gromeck/LatencyMeasure/Ressources/SVG/README

computer-158675.svg 
https://pixabay.com/de/vectors/computer-schreibtisch-arbeitsplatz-158675/
