gromeck/LatencyMeasure/Case/Dimensions-OLED-SSD-1306.png

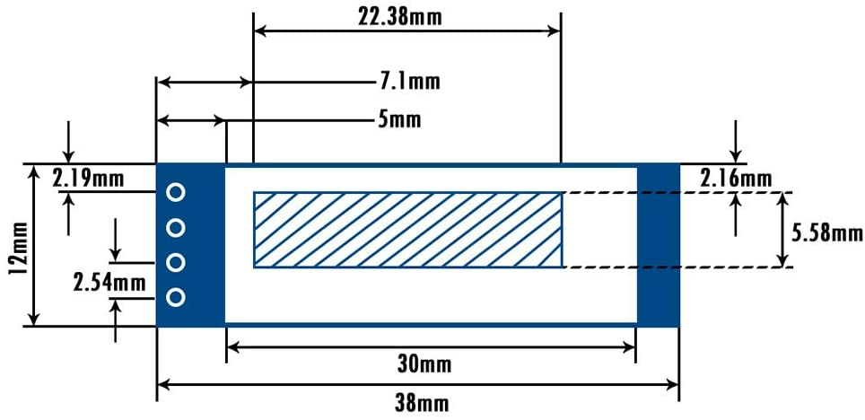
Case/Dimensions-OLED-SSD-1306.png
