gromeck/LatencyMeasure/TestClient/Qt4/README

	install Qt4 development environment (as root)

# apt install qt4-dev-tools

	build the client software

./build.sh
