gromeck/LatencyMeasure/Documentation/LatencyMeasure-Typical-Latencies.ods

Test Client | Environment | Window Manager | Test Client/Environment/Window Manager | min [ms] | avg [ms] | max [ms]
ncurses | console | - | ncurses/console/- | 12 | 21 | 29
ncurses via xterm | X11 | none | ncurses via xterm/X11/none | 10 | 19 | 21
ncurses via xterm | X11 | MATE | ncurses via xterm/X11/MATE | 31 | 44 | 66
FLTK | X11 | none | FLTK/X11/none | 10 | 15 | 23
FLTK | X11 | Gnome Classic | FLTK/X11/Gnome Classic | 26 | 32 | 39
FLTK | X11 | Gnome3 | FLTK/X11/Gnome3 | 26 | 32 | 40
FLTK | X11 | KDE “Plasma” | FLTK/X11/KDE “Plasma” | 14 | 21 | 29
GTK+ | X11 | KDE “Plasma” | GTK+/X11/KDE “Plasma” | 18 | 21 | 29
Qt4 | X11 | KDE “Plasma” | Qt4/X11/KDE “Plasma” | 18 | 30 | 53
FLTK | X11 | MATE | FLTK/X11/MATE | 28 | 41 | 55
GTK+ | X11 | MATE | GTK+/X11/MATE | 26 | 39 | 54
Qt4 | X11 | MATE | Qt4/X11/MATE | 31 | 47 | 54
HTML/Firefox 78.x | X11 | MATE | HTML/Firefox 78.x/X11/MATE | 55 | 65 | 78
HTML/Chrome 83.x | X11 | MATE | HTML/Chrome 83.x/X11/MATE | 67 | 73 | 80
