gromeck/LatencyMeasure/(threads)

Thread 2 (2020-10-19):

Check sensor area right before measurement cycle

gromeck, 2020-10-19:
Before a measurement cycle is done, the device should check that the sensor area is dark again.
This should not change any measuring behavior, but simply double check that the system under test is ready to be measured.

gromeck, 2020-10-19:
Implemented with commit bcda93945c8e4d4c52f2d0d78405658bab7e6465

Closed 2020-10-19.

Thread 4 (2020-10-25):

Improve calibration

gromeck, 2020-10-25:
The device should compute the optimal Uref during the calibration process.
The optimal Uref is the mean value between the lowest and highest Uin.

gromeck, 2020-11-02:
Empiric evaluation turned out that not the optimal Uref is not the mean between the lowest Uin (bright) and the hight Uin (dark), but a value of 80% of of the delta between lowest and highest Uin.
The optimization is implemented with commit d7d07f9f519d3749e5edcaf01a3c88896e707935

Closed 2020-11-02.
