gromeck/LatencyMeasure/Circuit/LatencyMeasure.pdf

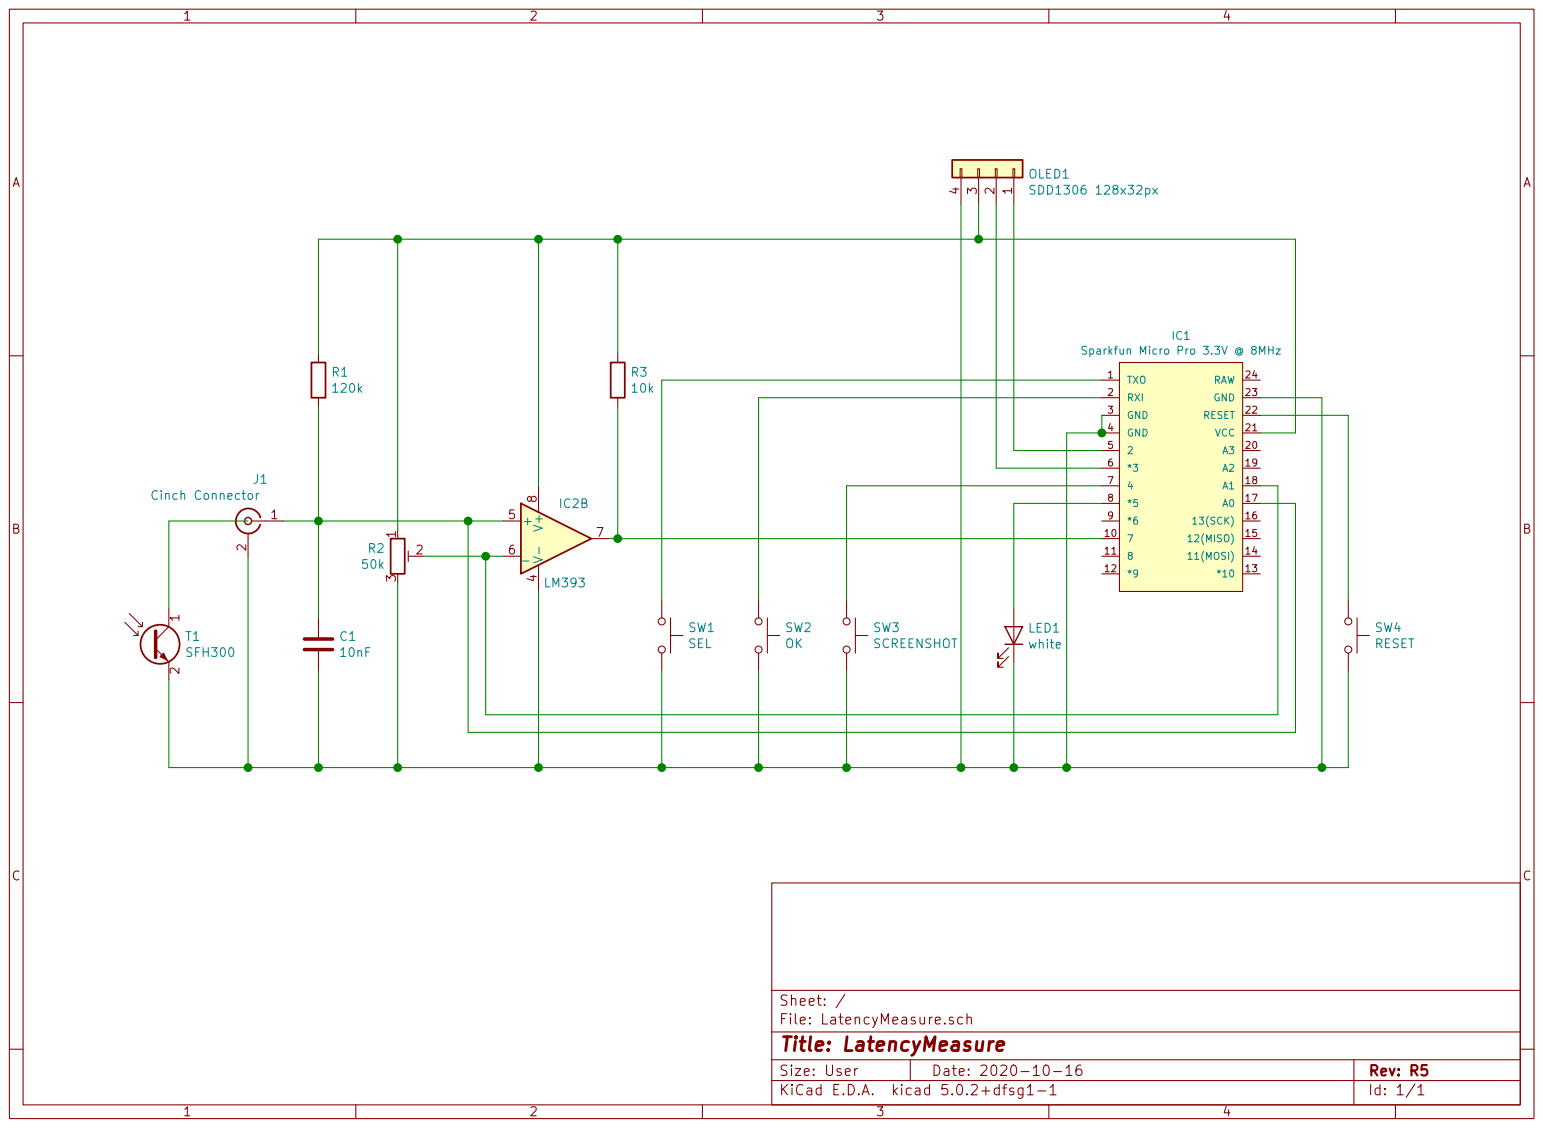
[picture p18: page 1]

File: LatencyMeasure.sch Sheet: / +

LED1 white
