gromeck/LatencyMeasure/Circuit/LatencyMeasure.sch

## KiCad design Circuit/LatencyMeasure.sch (2020-10-24)

Schematic: LatencyMeasure.sch

Parts:
C1: 10nF
IC1: Sparkfun Micro Pro 3.3V @ 8MHz; SPARKFUN_PRO_MICRO
IC2: LM393
J1: Cinch Connector
LED1: white
OLED1: SDD1306 128x32px
R1: 120k
R2: 50k
R3: 10k
SW1: SEL; SW_PUSH_6mm
SW2: OK; SW_PUSH_6mm
SW3: SCREENSHOT; SW_PUSH_6mm
SW4: RESET; SW_PUSH_6mm
T1: SFH300; LED_D5.0mm_Clear
U1: LM393
