gromeck/LatencyMeasure/LatencyMeasure/common.h

/*
  LatencyMeasure

  (c) 2020 Christian.Lorenz@gromeck.de

  common definitions


  This file is part of LatencyMeasure.

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
*/
#ifndef __COMMON_H__
#define __COMMON_H__ 1

#define SERIAL_BAUDRATE           115200

/*
**  in debug mode we produce more code and
**  timing accuracy is bad
*/
#define DEBUG                     0

#if DEBUG
#define FEATURE_CONFIG_MENU       0
#define FEATURE_TEST_TIMING       1
#define FEATURE_CALIBRATE_SENSOR  1
#define FEATURE_DEVICE_INFO       1
#define FEATURE_SCREENSHOT        1
#else
#define FEATURE_CONFIG_MENU       1
#define FEATURE_TEST_TIMING       1
#define FEATURE_CALIBRATE_SENSOR  1
#define FEATURE_DEVICE_INFO       1
#define FEATURE_SCREENSHOT        1
#endif

/*
**  the title of this sketch
*/
#define TITLE "LatencyMeasure"

#define GITHUB_URL  "github.com/gromeck/" TITLE

/*
**  pins for the buttons
*/
#define PIN_IN_BTNMODE    0
#define PIN_IN_BTNOK      1
#if FEATURE_SCREENSHOT
#define PIN_IN_SCREENSHOT 4
#endif

/*
**  pin used as the trigger input -- IRQ capable!
*/
#define PIN_IN_TRIGGER      7
#define PIN_IN_ANALOG_UIN   A0
#define PIN_IN_ANALOG_UREF  A1

/*
**  pin for the calibration LED
*/
#define PIN_OUT_LED       5


/*
   max latency
*/
#define MAX_LATENCY  5000

/*
   system includes
*/
#include <Arduino.h>
#include <stdarg.h>
#include <time.h>
#include "button.h"
#include "calibrate-sensor.h"
#include "config.h"
#include "display.h"
#include "device-info.h"
#include "measurement.h"
#include "test-timing.h"
#include "trigger.h"
#include "util.h"

#endif

/**/
