gromeck/LatencyMeasure/LatencyMeasure/trigger.cpp

/*
  LatencyMeasure

  (c) 2020 Christian.Lorenz@gromeck.de

  module to handle the sensor detection in an interrupt service routine


  This file is part of LatencyMeasure.

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
*/
#include "trigger.h"

static int _trigger_pin = 0;
static volatile unsigned long _trigger_start = 0;
static volatile unsigned long _trigger_time = 0;

/*
   interrupt service routine for our trigger

   we only register the first call
*/
static void _trigger_isr(void)
{
  if (!_trigger_time)
    _trigger_time = millis() - _trigger_start;
}

/*
   initialize the trigger by attaching the ISR
*/
void trigger_init(int pin)
{
  _trigger_pin = pin;
  pinMode(pin, INPUT_PULLUP);
  attachInterrupt(digitalPinToInterrupt(pin), _trigger_isr, FALLING);
}

/*
 * check if the trigger is ready
 * 
 * we do expect that the triggering pin is high before we wait for the trigger
 */
int trigger_ready(void)
{
  return (digitalRead(_trigger_pin) == HIGH) ? true : false;
}

/*
   reset the trigger time
*/
void trigger_reset(void)
{
  _trigger_time = 0;
  _trigger_start = millis();
}

/*
   wait for a given time for the trigger event
*/
unsigned long trigger_wait(int timetowait)
{
  unsigned long waittostop = millis() + timetowait;

  while (millis() < waittostop && !_trigger_time)
    delay(10);
  return _trigger_time;
}

/*
   return the time between the reset and the trigger event
*/
unsigned long trigger_time(void)
{
  return _trigger_time;
}/**/
