gromeck/LatencyMeasure/LatencyMeasure/calibrate-sensor.cpp

/*
  LatencyMeasure

  (c) 2020 Christian.Lorenz@gromeck.de

  module to handle the sensor calibration


  This file is part of LatencyMeasure.

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
*/
#include "calibrate-sensor.h"

#if FEATURE_CALIBRATE_SENSOR

void calibrate_sensor(void)
{
  int uref;
  int uin;
  int uin_min = ANALOG2VOLTS(ANALOG_RESOLUTION);
  int uin_max = 0;
  int uref_opt;
  int uref_delta;

  display_set_content("Place sensor over\nsensor area");
  display_menu("MENU", "OK");

  if (button_wait() == 0)
    return;

  display_menu("EXIT", NULL);

  do {
    /*
       read the state and the voltage from the IO pins
    */
    short state = (digitalRead(PIN_IN_TRIGGER) == LOW);
    uref = ANALOG2VOLTS(analogRead(PIN_IN_ANALOG_UREF));
    uin = ANALOG2VOLTS(analogRead(PIN_IN_ANALOG_UIN));

    /*
       compute the optimal Uref
    */
    if (uin < uin_min)
      uin_min = uin;
    if (uin > uin_max)
      uin_max = uin;

    /*
     * compute the optimal Uref and the actual delta
     */
    uref_opt = CALIBRATION_UREF_OPT(uin_min,uin_max);
    uref_delta = uref - uref_opt;

    DbgMsg("pin=%d  state=%d  Uin(min/max)=%d(%d/%d)  Uref(opt)=%d(%d)", digitalRead(PIN_IN_TRIGGER), state, uin, uin_min, uin_max, uref, uref_opt);

    /*
       show the current values to let the user calibrate the device Uref
    */
    display_set_content("Uref=%4dmV %c%2dmV %s\nUin =%4dmV  %s",
                        uref,
                        (uref_delta > 0) ? '-' : '+',abs(uref_delta),
                        (abs(uref_delta) < CALIBRATION_MAX_DELTA) ? "OK" : "",
                        uin,
                        (state) ? "BRIGHT" : "DARK");

    display_flush();
  } while (button_state(NULL) < 0);
}

#endif

/**/
