gromeck/LatencyMeasure/(commit log)

2020-08-20 INITIAL CHECK-IN
    [LatencyMeasure.scad, LatencyMeasure.sch]
2020-08-20 enabled all components
    [LatencyMeasure.scad]
2020-08-20 added GPL headers
    [LatencyMeasure.scad]
2020-08-21 fixed used pins of the micro controller
    [LatencyMeasure.sch]
2020-08-21 moved to Circuit
2020-08-21 moved to Case
2020-08-21 fixed paths to PNGs for Case and Circuit
2020-08-21 unified string: Place sensor here
2020-08-21 all features can now be configured into the code by a switch -- as the code segment is limited, this is useful for debugging; changed also the debugging and serial line handling; screenshot is now bu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
2020-08-21 added screenshots from the device display
2020-08-21 swapped pins 4 and 5 (Test Timing LED and Screenshot button)
    [LatencyMeasure.sch]
2020-08-23 reordered initialization as display_init() may use the buttons in case where we display the character map (ony debugging/test)
2020-10-03 increased the slackness for snaps from 0.1 to 0.2; removed the mount variant for suction cups;gave the clip notches also a slackness
    [LatencyMeasure.scad]
2020-10-07 swapped pin 0 and 1
    [common.h]
2020-10-07 improved the mount and case -- still work in progress
    [LatencyMeasure.scad]
2020-10-07 corrected R1 and R2, swapped buttons 1 and 2
    [LatencyMeasure.sch]
2020-10-07 added PCB version
2020-10-12 swapped buttons once more
    [common.h]
2020-10-12 fist working version
    [LatencyMeasure.scad]
2020-10-16 added note for the PCB Layout
2020-10-16 added link to Sparkfun KiCAD lib
2020-10-16 added OO lockfiles and lib sym-lib-table from KiCAD
2020-10-16 made a new revision after the device was made three time
    [LatencyMeasure.sch]
2020-10-16 last improvements before the first threee devices were done
    [LatencyMeasure.scad]
2020-10-17 set the flags to generate all the final parts
    [LatencyMeasure.scad]
2020-10-18 some more explenations for the enclosure
2020-10-19 reduced code by dropping/shorten some strings
    [device-info.cpp]
2020-10-24 added capacitor C1
    [LatencyMeasure.sch]
2020-10-25 implemented hook to get the current GIT tag/version into the code during build
2020-10-25 the GIT version of the SW build is now available in the device info
2020-10-26 due to the limited memory footprint in the controller, I removed the device type from the device info
2020-10-26 moved the ANALOG2VOLTAGE() to calibration.h
2020-10-27 improved the calibration proecdure
2020-11-02 removed button_state() from measurement loop
2020-11-02 moved the computation of the optimal Uref into a macro; renamed MAX_CALIBRATION_DELTA to CALIBRATION_MAX_DELTA; got rid of float values in ANALOG2VOLTS(); increased the OK window for the calibration 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
2020-11-02 updated the calibration procedure
